eroson24/FEHrobotproject/images/proteus_electricalDocumentation.png

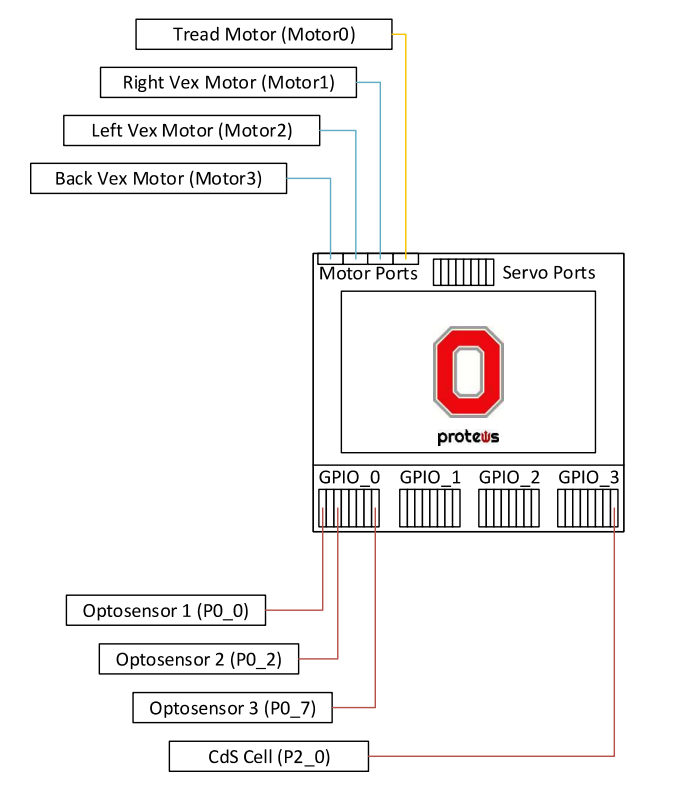
images/proteus_electricalDocumentation.png
