eroson24/FEHrobotproject/images/robot_projectSchedule.png

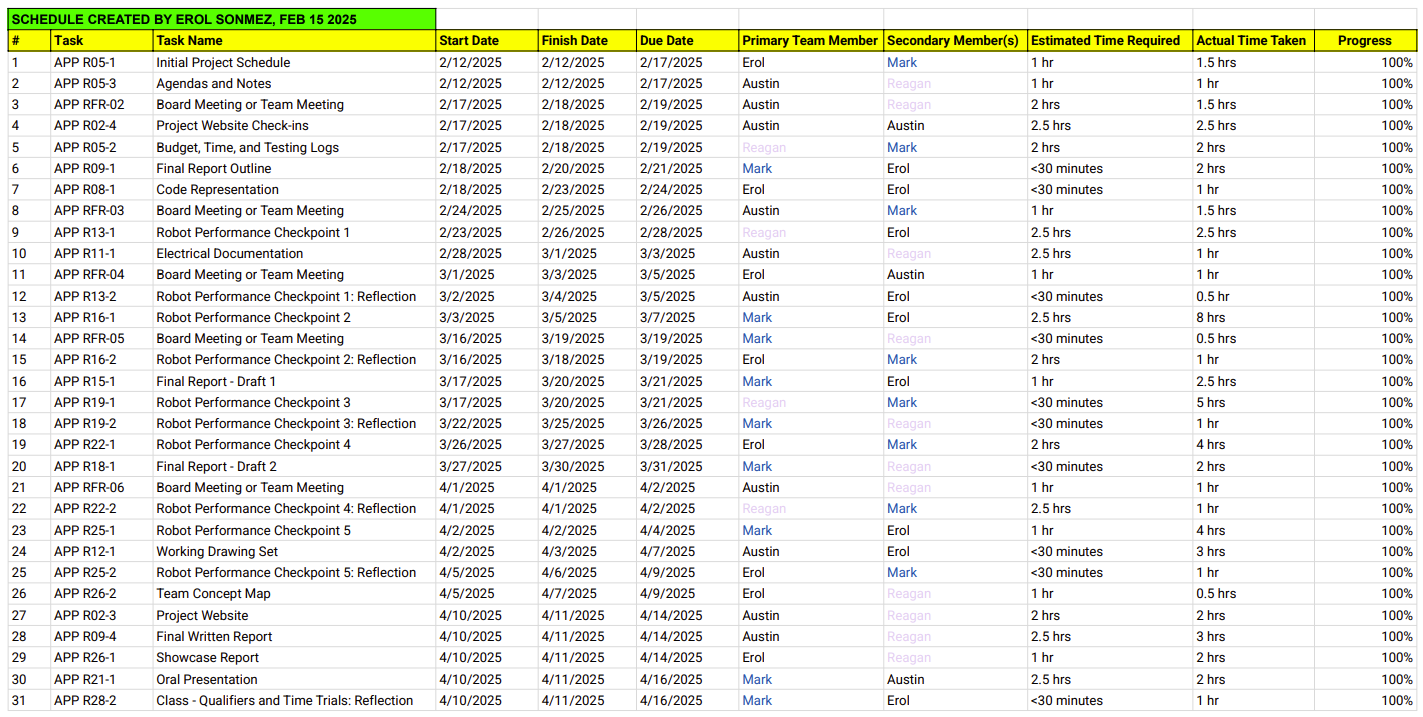
images/robot_projectSchedule.png
