eroson24/FEHrobotproject/(commit log)

2025-02-10 Edited exploration 3 start button behavior
2025-02-10 Removed start button
2025-02-17 Working on Exploration 2 -- Shaft Encoding
2025-02-21 Exploration archived. Testing vex motor speeds.
2025-02-24 Declarations of motor. Starting main function.
2025-03-25 Milestone 3 Distance sensor navigation with shaft encoding
2025-04-09 Humidifier button progress
